fan24fan/AGC_digital_potentiometer/report/README.md

# ElegantPaper

[Homepage](https://elegantlatex.org/) | [Github](https://github.com/ElegantLaTeX/ElegantPaper) | [CTAN](https://ctan.org/pkg/elegantpaper) | [Download](https://github.com/ElegantLaTeX/ElegantPaper/releases) | [Wiki](https://github.com/ElegantLaTeX/ElegantPaper/wiki) | [Weibo](https://weibo.com/elegantlatex)






ElegantPaper is designed for writing a working paper, especially for economics students. This template is based on the standard LaTeX article class. The goal of this template is to make the writing process easier and more comfortable. You can get rid of all the worries about the format. Just enjoy it! If you have any questions, suggestions or bug reports, you can create issues or email us at elegantlatex2e@gmail.com.

此模板基于 LaTeX 的 article 类，专为工作论文写作而设计。设计这个模板的初衷是让作者不用关心工作论文的格式，专心写作，从而有更加舒适，简便的写作体验。如果你有其他问题、建议或者报告 bug，可以提交 issues 或者给我们发邮件：elegantlatex2e@gmail.com。用户 QQ 交流群（Q 群：692108391），欢迎加入。

The official user guide is [here](https://github.com/ElegantLaTeX/ElegantPaper/releases), or you can refer to the [wiki](https://github.com/ElegantLaTeX/ElegantPaper/wiki).

模板使用说明请参见[模板文档](https://github.com/ElegantLaTeX/ElegantPaper/releases)，或者 [wiki](https://github.com/ElegantLaTeX/ElegantPaper/wiki)。

## License

This work is released under the LaTeX Project Public License, v1.3c or later. 

本模板发布遵循 LaTeX 项目公共许可证 1.3c 或更高版本。 
=======
