fan24fan/AGC_digital_potentiometer/三个题目.md

## 题目一

题目：自动增益控制放大器

### 参考

https://blog.csdn.net/m0_37921318/article/details/123164418

## 题目二

题目：https://www.nuedc-training.com.cn/index/news/details/new_id/226

### 参考

https://blog.csdn.net/struggle_success/article/details/135726398

## 题目三

题目：https://blog.csdn.net/m0_73833939/article/details/130334676

### 参考
