fan24fan/AGC_digital_potentiometer/report/数字电位器真1.PDF

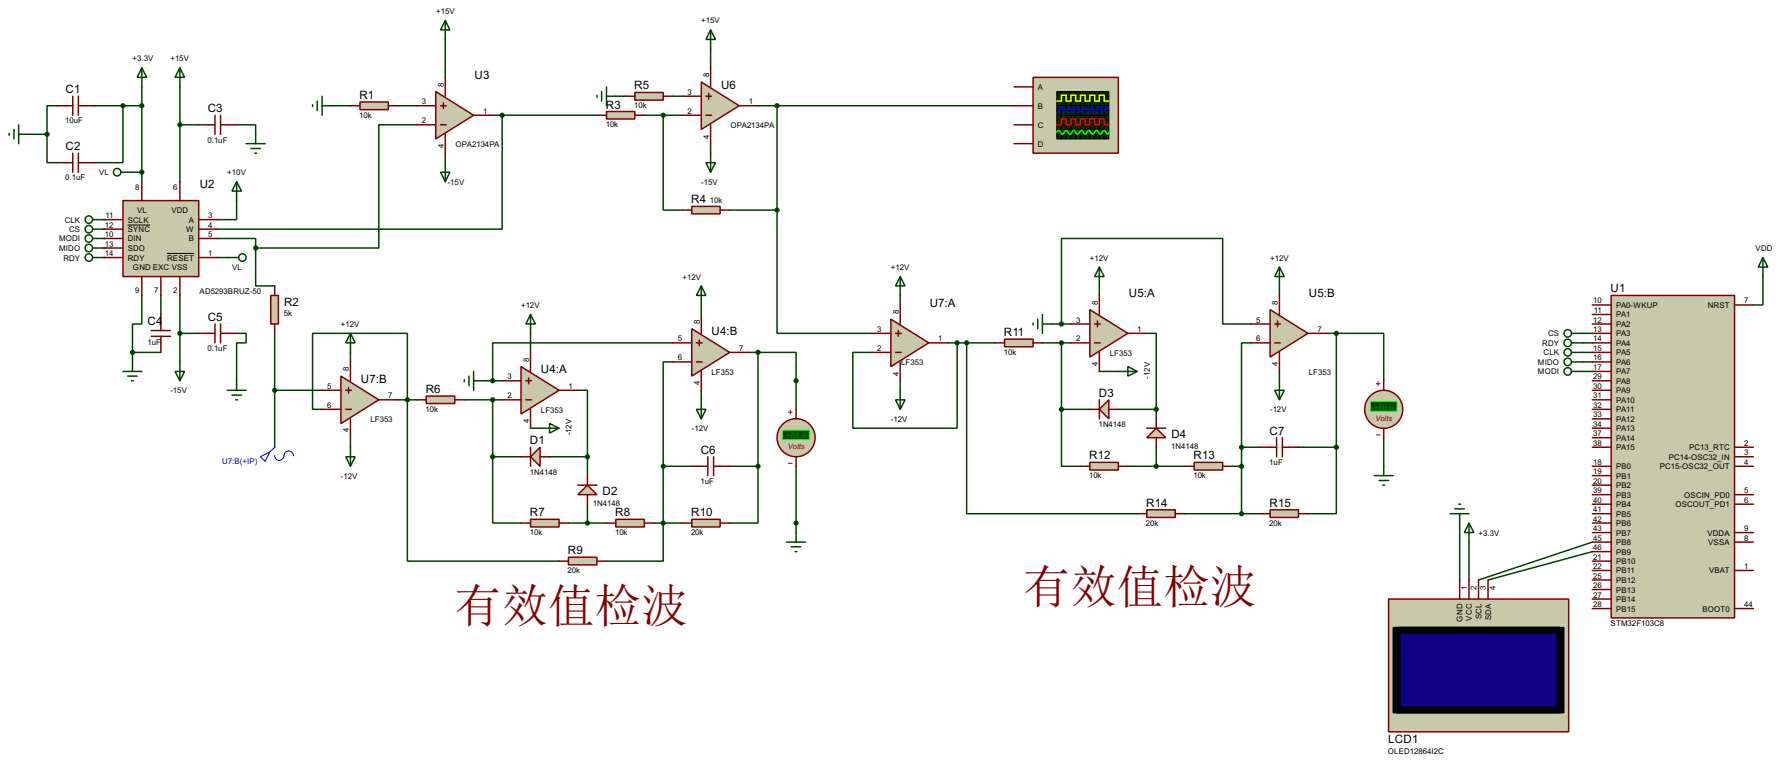
[picture p22: page 1]
