fan24fan/AGC_digital_potentiometer/(list of files, drawings)

Other design files:
PCB/【数字电位器】AD5293.eprj
Simulation/DAC.ms14
Simulation/数字电位器.pdsprj
题目2原理图and仿真/keshe.ms14
题目2原理图and仿真/SCH_模电课设_2024-01-21.json
