fan24fan/AGC_digital_potentiometer/Code/数字电位器AGC/software/oled.c

/************************************************************************************
//注意：K系列模块驱动程序是免费资源，任何收费行为都是盗用资料行为
//店名：(咱们电子科技）淘宝链接: https://shop149406681.taobao.com/?spm=a1z10.1-c.0.0.64cb457fKzgKea 
//淘宝店内搜索关键词：ADS1115
//版 本 号   : v2.0
//作    者   : ZMD_001
//咱们电子科技QQ :1795190213   微信：15770663680
//CSDN  （基本参数，资源更新列表，所有接线说明）   :单片机代码搬运工(搜索关键词：K_A37_005)
//BILIBILI（演示视频） :咱们电子科技(搜索关键词：K_A37_005)
//生成日期   : 2023-6-21
//最近修改   : 2023-11-21
//下载器 ：STLINK 链接：https://item.taobao.com/item.htm?ft=t&id=740772318848
//  功能描述   : ADS1115块测试程序
//  测试条件   : STM32F103C8T6   晶振8M  系统时钟72M
接线
ADS1115--------------------------------STM32F103C8T6
VCC-- ---------------------------------5V
GND- ----------------------------------GND
SCL- ----------------------------------PB_4 //SCL
SDA- ----------------------------------PB_3 //SDA	

OLED0.96
VCC-- ---------------------------------3.3V
GND- ----------------------------------GND
SCL- ----------------------------------PB_8 //SCL
SDA- ----------------------------------PB_9 //SDA	
*************************************************************************************/
#include "oled.h"
#include "stdlib.h"
#include "oledfont.h"
#include "delay.h"
//OLED的显存
//存放格式如下.
//[0]0 1 2 3 ... 127	
//[1]0 1 2 3 ... 127	
//[2]0 1 2 3 ... 127	
//[3]0 1 2 3 ... 127	
//[4]0 1 2 3 ... 127	
//[5]0 1 2 3 ... 127	
//[6]0 1 2 3 ... 127	
//[7]0 1 2 3 ... 127 			   
/**********************************************
//IIC Start
**********************************************/
/**********************************************
//IIC Start
**********************************************/
void OLED_IIC_Start()
{

		OLED_SCLK_Set();
		OLED_SDIN_Set();
		OLED_SDIN_Clr();
		OLED_SCLK_Clr();
}

/**********************************************
//IIC Stop
**********************************************/
void OLED_IIC_Stop()
{
		OLED_SCLK_Set() ;
		//	OLED_SCLK_Clr();
		OLED_SDIN_Clr();
		OLED_SDIN_Set();
	
}

void OLED_IIC_Wait_Ack()
{

	//GPIOB->CRH &= 0XFFF0FFFF;	//设置PB12为上拉输入模式
	//GPIOB->CRH |= 0x00080000;
//	OLED_SDA = 1;
//	delay_us(1);
	//OLED_SCL = 1;
	//delay_us(50000);
/*	while(1)
	{
		if(!OLED_SDA)				//判断是否接收到OLED 应答信号
		{
			//GPIOB->CRH &= 0XFFF0FFFF;	//设置PB12为通用推免输出模式
			//GPIOB->CRH |= 0x00030000;
			return;
		}
	}
*/
		OLED_SCLK_Set();
		OLED_SCLK_Clr();
}
/**********************************************
// IIC Write byte
**********************************************/

void OLED_Write_IIC_Byte(unsigned char IIC_Byte)
{
		unsigned char i;
		unsigned char m,da;
		da=IIC_Byte;
		OLED_SCLK_Clr();
		for(i=0;i<8;i++)		
		{
				m=da;
				//	OLED_SCLK_Clr();
				m=m&0x80;
				if(m==0x80)
				{OLED_SDIN_Set();}
				else OLED_SDIN_Clr();
				da=da<<1;
				OLED_SCLK_Set();
				OLED_SCLK_Clr();
		}
}
/**********************************************
// IIC Write Command
**********************************************/
void OLED_Write_IIC_Command(unsigned char IIC_Command)
{
			OLED_IIC_Start();
			OLED_Write_IIC_Byte(0x78);            //Slave address,SA0=0
			OLED_IIC_Wait_Ack();	
			OLED_Write_IIC_Byte(0x00);			//write command
			OLED_IIC_Wait_Ack();	
			OLED_Write_IIC_Byte(IIC_Command); 
			OLED_IIC_Wait_Ack();	
			OLED_IIC_Stop();
}
/**********************************************
// IIC Write Data
**********************************************/
void OLED_Write_IIC_Data(unsigned char IIC_Data)
{
			OLED_IIC_Start();
			OLED_Write_IIC_Byte(0x78);			//D/C#=0; R/W#=0
			OLED_IIC_Wait_Ack();	
			OLED_Write_IIC_Byte(0x40);			//write data
			OLED_IIC_Wait_Ack();	
			OLED_Write_IIC_Byte(IIC_Data);
			OLED_IIC_Wait_Ack();	
			OLED_IIC_Stop();
}
void OLED_WR_Byte(unsigned dat,unsigned cmd)
{
		if(cmd)
		{
				OLED_Write_IIC_Data(dat);
		}
		else
		{
				OLED_Write_IIC_Command(dat);
		}
}


/********************************************
// fill_Picture
********************************************/
void fill_picture(unsigned char fill_Data)
{
		unsigned char m,n;
		for(m=0;m<8;m++)
		{
				OLED_WR_Byte(0xb0+m,0);		//page0-page1
				OLED_WR_Byte(0x00,0);		//low column start address
				OLED_WR_Byte(0x10,0);		//high column start address
				for(n=0;n<128;n++)
				{
						OLED_WR_Byte(fill_Data,1);
				}
		}
}


/***********************Delay****************************************/
void Delay_50ms(unsigned int Del_50ms)
{
		unsigned int m;
		for(;Del_50ms>0;Del_50ms--)
				for(m=6245;m>0;m--);
}

void Delay_1ms(unsigned int Del_1ms)
{
		unsigned char j;
		while(Del_1ms--)
		{	
				for(j=0;j<123;j++);
		}
}

//坐标设置

void OLED_Set_Pos(unsigned char x, unsigned char y) 
{ 	
		OLED_WR_Byte(0xb0+y,OLED_CMD);
		OLED_WR_Byte(((x&0xf0)>>4)|0x10,OLED_CMD);
		OLED_WR_Byte((x&0x0f),OLED_CMD); 
}   	  
//开启OLED显示    
void OLED_Display_On(void)
{
		OLED_WR_Byte(0X8D,OLED_CMD);  //SET DCDC命令
		OLED_WR_Byte(0X14,OLED_CMD);  //DCDC ON
		OLED_WR_Byte(0XAF,OLED_CMD);  //DISPLAY ON
}
//关闭OLED显示     
void OLED_Display_Off(void)
{
		OLED_WR_Byte(0X8D,OLED_CMD);  //SET DCDC命令
		OLED_WR_Byte(0X10,OLED_CMD);  //DCDC OFF
		OLED_WR_Byte(0XAE,OLED_CMD);  //DISPLAY OFF
}		   			 
//清屏函数,清完屏,整个屏幕是黑色的!和没点亮一样!!!	  
void OLED_Clear(void)  
{  
		uint8_t i,n;		    
		for(i=0;i<8;i++)  
		{  
		OLED_WR_Byte (0xb0+i,OLED_CMD);    //设置页地址（0~7）
		OLED_WR_Byte (0x00,OLED_CMD);      //设置显示位置—列低地址
		OLED_WR_Byte (0x10,OLED_CMD);      //设置显示位置—列高地址   
		for(n=0;n<128;n++)OLED_WR_Byte(0,OLED_DATA); 
		} //更新显示
}
void OLED_On(void)  
{  
	uint8_t i,n;		    
	for(i=0;i<8;i++)  
	{  
		OLED_WR_Byte (0xb0+i,OLED_CMD);    //设置页地址（0~7）
		OLED_WR_Byte (0x00,OLED_CMD);      //设置显示位置—列低地址
		OLED_WR_Byte (0x10,OLED_CMD);      //设置显示位置—列高地址   
		for(n=0;n<128;n++)OLED_WR_Byte(1,OLED_DATA); 
	} //更新显示
}
//在指定位置显示一个字符,包括部分字符
//x:0~127
//y:0~63
//mode:0,反白显示;1,正常显示				 
//size:选择字体 16/12 
void OLED_ShowChar(uint8_t x,uint8_t y,uint8_t chr,uint8_t Char_Size)
{      	
	unsigned char c=0,i=0;	
		c=chr-' ';//得到偏移后的值			
		if(x>Max_Column-1){x=0;y=y+2;}
		if(Char_Size ==16)
			{
			OLED_Set_Pos(x,y);	
			for(i=0;i<8;i++)
			OLED_WR_Byte(F8X16[c*16+i],OLED_DATA);
			OLED_Set_Pos(x,y+1);
			for(i=0;i<8;i++)
			OLED_WR_Byte(F8X16[c*16+i+8],OLED_DATA);
			}
			else {	
				OLED_Set_Pos(x,y);
				for(i=0;i<6;i++)
				OLED_WR_Byte(F6x8[c][i],OLED_DATA);
				
			}
}
//m^n函数
u32 oled_pow(uint8_t m,uint8_t n)
{
	u32 result=1;	 
	while(n--)result*=m;    
	return result;
}				  
//显示2个数字
//x,y :起点坐标	 
//len :数字的位数
//size:字体大小
//mode:模式	0,填充模式;1,叠加模式
//num:数值(0~4294967295);	 		  
void OLED_ShowNumber(uint8_t x,uint8_t y,u32 num,uint8_t len,uint8_t size2)
{         	
	uint8_t t,temp;
	uint8_t enshow=0;						   
	for(t=0;t<len;t++)
	{
		temp=(num/oled_pow(10,len-t-1))%10;
		if(enshow==0&&t<(len-1))
		{
			if(temp==0)
			{
				OLED_ShowChar(x+(size2/2)*t,y,' ',size2);
				continue;
			}else enshow=1; 
		 	 
		}
	 	OLED_ShowChar(x+(size2/2)*t,y,temp+'0',size2); 
	}
} 
//显示一个字符号串
void OLED_ShowString(uint8_t x,uint8_t y,uint8_t *chr,uint8_t Char_Size)
{
	while (*chr!='\0')
	{		OLED_ShowChar(x,y,*chr,Char_Size);
			x+=8;
		if(x>120){x=0;y+=2;}
			chr++;
	}
}
//显示汉字
void OLED_ShowCHinese(uint8_t x,uint8_t y,uint8_t no)
{      			    
		uint8_t t,adder=0;
		OLED_Set_Pos(x,y);	
		for(t=0;t<16;t++)
		{
				OLED_WR_Byte(Hzk[2*no][t],OLED_DATA);
				adder+=1;
		}	
		OLED_Set_Pos(x,y+1);	
		for(t=0;t<16;t++)
		{	
				OLED_WR_Byte(Hzk[2*no+1][t],OLED_DATA);
				adder+=1;
		}					
}
/***********功能描述：显示显示BMP图片128×64起始点坐标(x,y),x的范围0～127，y为页的范围0～7*****************/
void OLED_DrawBMP(unsigned char x0, unsigned char y0,unsigned char x1, unsigned char y1,unsigned char BMP[])
{ 	
		unsigned int j=0;
		unsigned char x,y;

		if(y1%8==0) y=y1/8;      
		else y=y1/8+1;
		for(y=y0;y<y1;y++)
		{
				OLED_Set_Pos(x0,y);
				for(x=x0;x<x1;x++)
				{      
						OLED_WR_Byte(BMP[j++],OLED_DATA);	    	
				}
		}
} 
void OLED_Float(unsigned char Y,unsigned char X,double real,unsigned char N) 
{
		unsigned char   i_Count=1;
		unsigned char   n[12]={0};
		long   j=1;  
		int    real_int=0;
		double decimal=0;
		unsigned int   real_decimal=0;
		if(real<0)
		{
				real_int=(int)(-real);
		}
		else
		{
				real_int=(int)real;
		}
		decimal=real-real_int;
		real_decimal=decimal*1e4;
		while(real_int/10/j!=0)
		{
				j=j*10;i_Count++;  
		} 
		n[0]=(real_int/10000)%10; 
		n[1]=(real_int/1000)%10;
		n[2]=(real_int/100)%10;
		n[3]=(real_int/10)%10;
		n[4]=(real_int/1)%10; 
		n[5]='.';
		n[6]=(real_decimal/1000)%10;
		n[7]=(real_decimal/100)%10;
		n[8]=(real_decimal/10)%10;
		n[9]=real_decimal%10;
		n[6+N]='\0'; 
		for(j=0;j<10;j++) n[j]=n[j]+16+32;
		if(real<0) 
		{		 
				i_Count+=1;
				n[5-i_Count]='-';
		}
		n[5]='.';
		n[6+N]='\0';   
		OLED_ShowString(X,Y,&n[5-i_Count],16); 
}

 void OLED_Float2(unsigned char Y,unsigned char X,double real,unsigned char N1,unsigned char N2) 
{
		unsigned char   i_Count=1;
		unsigned char   n[12]={0};
		long   j=1;  
		unsigned int   real_int=0;
		double decimal=0;
		unsigned int   real_decimal=0;
		X=X*8;
		real_int=(int)real;
		//Dis_Num(2,0,real_int,5);
		decimal=real-real_int;
		real_decimal=decimal*1e4;
		//Dis_Num(2,6,real_decimal,4);
		while(real_int/10/j!=0)
		{
				j=j*10;i_Count++;  
		} 
		n[0]=(real_int/10000)%10; 
		n[1]=(real_int/1000)%10;
		n[2]=(real_int/100)%10;
		n[3]=(real_int/10)%10;

		n[5]='.';
		n[6]=(real_decimal/1000)%10;
		n[7]=(real_decimal/100)%10;
		n[8]=(real_decimal/10)%10;
		n[9]=real_decimal%10;
		n[6+N2]='\0'; 
		for(j=0;j<10;j++) n[j]=n[j]+16+32;
		n[5]='.';
		n[6+N2]='\0';   
		OLED_ShowString(X,Y,&n[5-N1],12); 
}

void OLED_Num2(unsigned char x,unsigned char y, int number)
{
		unsigned char shi,ge;
		int num =number;
		if(num<0)
		{ 
				num=-num;
				shi=num%100/10;
				ge=num%10;
				OLED_fuhao_write(x,y,13); 
				OLED_Num_write(x+1,y,shi);
				OLED_Num_write(x+2,y,ge); 
		} 
		else
		{

				shi=num%100/10;
				ge=num%10;
				OLED_fuhao_write(x,y,11);
				OLED_Num_write(x+1,y,shi);
				OLED_Num_write(x+2,y,ge); 
		}

}

void OLED_Num3(unsigned char x,unsigned char y,int number)
{
  unsigned char ge,shi,bai;
	int num =number;
	if(num<0)
	{
		    num=-num;
		    OLED_fuhao_write(x,y,13); //显示-号
        ge = num %10;
        shi = num/10%10;
        bai = num/100;
        OLED_Num_write(x+3,y,ge);
        OLED_Num_write(x+2,y,shi);
        OLED_Num_write(x+1,y,bai);
	}
	else
	{
       OLED_fuhao_write(x,y,11);
        ge = num %10;
        shi = num/10 %10;
        bai = num/100;
        OLED_Num_write(x+3,y,ge);
        OLED_Num_write(x+2,y,shi);
        OLED_Num_write(x+1,y,bai);
  }
}

void OLED_Num4(unsigned char x,unsigned char y, int number)
{
		unsigned char qian,bai,shi,ge;
		int num =number;
		if(num<0)
		{
				num=-num;
		}
		qian=num/1000;
		bai=num%1000/100;
		shi=num%100/10;
		ge=num%10;

		OLED_Num_write(x,y,qian);
		OLED_Num_write(x+1,y,bai);
		OLED_Num_write(x+2,y,shi);
		OLED_Num_write(x+3,y,ge);
}

void OLED_Num_write(unsigned char x,unsigned char y,unsigned char asc) 
{
		int i=0;
		OLED_Set_Pos(x*6,y);
		for(i=0;i<6;i++)
		{
			 OLED_WR_Byte(F6x8[asc+16][i],OLED_DATA);         
		}
}	
void OLED_fuhao_write(unsigned char x,unsigned char y,unsigned char asc) 
{

	  int i=0;
    OLED_Set_Pos(x*6,y);
    for(i=0;i<6;i++)
    {
       OLED_WR_Byte(F6x8[asc][i],OLED_DATA);         
    }
 
}			

void OLED_Num5(unsigned char x,unsigned char y,unsigned int number)
{
        unsigned char wan,qian,bai,shi,ge;
        wan=number/10000;
	    	qian = number%10000/1000;
        bai=number%1000/100;
        shi=number%100/10;
        ge=number%10;
        OLED_Num_write(x,y,wan);
        OLED_Num_write(x+1,y,qian);
        OLED_Num_write(x+2,y,bai);
        OLED_Num_write(x+3,y,shi);
		    OLED_Num_write(x+4,y,ge);
}
void GPIO_OLED_Init(void)
{
		GPIO_InitTypeDef  GPIO_InitStructure;
		RCC_APB2PeriphClockCmd(RCC_APB2Periph_GPIOB|RCC_APB2Periph_AFIO, ENABLE);	 //使能B端口时钟
		GPIO_PinRemapConfig(GPIO_Remap_SWJ_JTAGDisable,ENABLE); 
		GPIO_InitStructure.GPIO_Pin = GPIO_Pin_8|GPIO_Pin_9;	 
		GPIO_InitStructure.GPIO_Mode = GPIO_Mode_Out_PP; 		 //推挽输出
		GPIO_InitStructure.GPIO_Speed = GPIO_Speed_50MHz;//速度50MHz
		GPIO_Init(GPIOB, &GPIO_InitStructure);	  //初始化GPIOB8,9
		GPIO_SetBits(GPIOB,GPIO_Pin_8|GPIO_Pin_9);	

	
}
//初始化SSD1306					    
void OLED_Init(void)
{
 
  GPIO_OLED_Init();
	DelayMs(800);
	OLED_WR_Byte(0xAE,OLED_CMD);//--display off
	OLED_WR_Byte(0x00,OLED_CMD);//---set low column address
	OLED_WR_Byte(0x10,OLED_CMD);//---set high column address
	OLED_WR_Byte(0x40,OLED_CMD);//--set start line address  
	OLED_WR_Byte(0xB0,OLED_CMD);//--set page address
	OLED_WR_Byte(0x81,OLED_CMD); // contract control
	OLED_WR_Byte(0xFF,OLED_CMD);//--128   
	OLED_WR_Byte(0xA1,OLED_CMD);//set segment remap 
	OLED_WR_Byte(0xA6,OLED_CMD);//--normal / reverse
	OLED_WR_Byte(0xA8,OLED_CMD);//--set multiplex ratio(1 to 64)
	OLED_WR_Byte(0x3F,OLED_CMD);//--1/32 duty
	OLED_WR_Byte(0xC8,OLED_CMD);//Com scan direction
	OLED_WR_Byte(0xD3,OLED_CMD);//-set display offset
	OLED_WR_Byte(0x00,OLED_CMD);//
	
	OLED_WR_Byte(0xD5,OLED_CMD);//set osc division
	OLED_WR_Byte(0x80,OLED_CMD);//
	
	OLED_WR_Byte(0xD8,OLED_CMD);//set area color mode off
	OLED_WR_Byte(0x05,OLED_CMD);//
	
	OLED_WR_Byte(0xD9,OLED_CMD);//Set Pre-Charge Period
	OLED_WR_Byte(0xF1,OLED_CMD);//
	
	OLED_WR_Byte(0xDA,OLED_CMD);//set com pin configuartion
	OLED_WR_Byte(0x12,OLED_CMD);//
	
	OLED_WR_Byte(0xDB,OLED_CMD);//set Vcomh
	OLED_WR_Byte(0x30,OLED_CMD);//
	
	OLED_WR_Byte(0x8D,OLED_CMD);//set charge pump enable
	OLED_WR_Byte(0x14,OLED_CMD);//
	
	OLED_WR_Byte(0xAF,OLED_CMD);//--turn on oled panel
}  
