fan24fan/AGC_digital_potentiometer/Code/数字电位器AGC/hardware/Key.c

#include "stm32f10x.h"                  // Device header
#include "Delay.h"

void Key_Init(void)
{
	RCC_APB2PeriphClockCmd(RCC_APB2Periph_GPIOE, ENABLE);
	
	GPIO_InitTypeDef GPIO_InitStructure;
	GPIO_InitStructure.GPIO_Mode = GPIO_Mode_IPU;
	GPIO_InitStructure.GPIO_Pin = GPIO_Pin_3 | GPIO_Pin_4;
	GPIO_InitStructure.GPIO_Speed = GPIO_Speed_50MHz;
	GPIO_Init(GPIOE, &GPIO_InitStructure);
}

//KEY0:2
uint8_t Key_GetNum(void)
{
	uint8_t KeyNum = 0;
	if (GPIO_ReadInputDataBit(GPIOE, GPIO_Pin_3) == 0)
	{
		DelayMs(20);
		while (GPIO_ReadInputDataBit(GPIOE, GPIO_Pin_3) == 0);
		DelayMs(20);
		KeyNum = 1;
	}
	if (GPIO_ReadInputDataBit(GPIOE, GPIO_Pin_4) == 0)
	{
		DelayMs(20);
		while (GPIO_ReadInputDataBit(GPIOE, GPIO_Pin_4) == 0);
		DelayMs(20);
		KeyNum = 2;
	}
	
	return KeyNum;
}
