fan24fan/AGC_digital_potentiometer/Code/数字电位器AGC/software/MySPI.c

#include "stm32f10x.h"                  // Device header
#include "MySPI.h"

void SPI1_Init(void)
{
 	GPIO_InitTypeDef GPIO_InitStructure;
  SPI_InitTypeDef  SPI_InitStructure;
 
	RCC_APB2PeriphClockCmd(	RCC_APB2Periph_GPIOA, ENABLE );//PORTA时钟使能 
	RCC_APB2PeriphClockCmd(	RCC_APB2Periph_SPI1,  ENABLE );//SPI1时钟使能 	
 
	GPIO_InitStructure.GPIO_Pin = GPIO_Pin_5 | GPIO_Pin_6 | GPIO_Pin_7;
	GPIO_InitStructure.GPIO_Mode = GPIO_Mode_AF_PP;  //PB5/6/7复用推挽输出 
	GPIO_InitStructure.GPIO_Speed = GPIO_Speed_50MHz;
	GPIO_Init(GPIOA, &GPIO_InitStructure);//初始化GPIOB
 
 	GPIO_SetBits(GPIOA, GPIO_Pin_5 | GPIO_Pin_6 | GPIO_Pin_7);  //PB5/6/7上拉
 
	SPI_InitStructure.SPI_Direction = SPI_Direction_2Lines_FullDuplex;  //设置SPI单向或者双向的数据模式:SPI设置为双线双向全双工
	SPI_InitStructure.SPI_Mode = SPI_Mode_Master;		//设置SPI工作模式:设置为主SPI
	SPI_InitStructure.SPI_DataSize = SPI_DataSize_8b;		//设置SPI的数据大小:SPI发送接收8位帧结构
	SPI_InitStructure.SPI_CPOL = SPI_CPOL_Low;		//串行同步时钟的空闲状态为低电平
	SPI_InitStructure.SPI_CPHA = SPI_CPHA_2Edge;	//串行同步时钟的第二个跳变沿（上升或下降）数据被采样
	SPI_InitStructure.SPI_NSS = SPI_NSS_Soft;		//NSS信号由硬件（NSS管脚）还是软件（使用SSI位）管理:内部NSS信号有SSI位控制
	SPI_InitStructure.SPI_BaudRatePrescaler = SPI_BaudRatePrescaler_256;		//定义波特率预分频的值:波特率预分频值为256
	SPI_InitStructure.SPI_FirstBit = SPI_FirstBit_MSB;	//指定数据传输从MSB位还是LSB位开始:数据传输从MSB位开始
	SPI_InitStructure.SPI_CRCPolynomial = 7;	//CRC值计算的多项式
	SPI_Init(SPI1, &SPI_InitStructure);  //根据SPI_InitStruct中指定的参数初始化外设SPIx寄存器
 
	SPI_Cmd(SPI1, ENABLE); //使能SPI外设
	
	SPI1_ReadWriteByte(0xff);//启动传输		 
 
 
}   
 
void SPI1_SetSpeed(u8 SPI_BaudRatePrescaler)
{
  assert_param(IS_SPI_BAUDRATE_PRESCALER(SPI_BaudRatePrescaler));
	SPI1->CR1&=0XFFC7;
	SPI1->CR1|=SPI_BaudRatePrescaler;	//设置SPI1速度 
	SPI_Cmd(SPI1,ENABLE); 
 
} 
 
//SPIx 读写一个字节
//TxData:要写入的字节
//返回值:读取到的字节
u8 SPI1_ReadWriteByte(u8 TxData)
{		
	u8 retry=0;				 	
	while (SPI_I2S_GetFlagStatus(SPI1, SPI_I2S_FLAG_TXE) == RESET) //检查指定的SPI标志位设置与否:发送缓存空标志位
		{
		retry++;
		if(retry>200)return 0;
		}			  
	SPI_I2S_SendData(SPI1, TxData); //通过外设SPIx发送一个数据
	retry=0;
 
	while (SPI_I2S_GetFlagStatus(SPI1, SPI_I2S_FLAG_RXNE) == RESET) //检查指定的SPI标志位设置与否:接受缓存非空标志位
		{
		retry++;
		if(retry>200)return 0;
		}	  						    
	return SPI_I2S_ReceiveData(SPI1); //返回通过SPIx最近接收的数据					    
}
