fan24fan/AGC_digital_potentiometer/(commit log)

2024-05-18 第二次提交3:00
2024-05-19 第四次提交
2024-05-21 定稿-加页码
